chris-iot/esp8266_hardware/README.md

# esp8266_hardware
All layouts and schematics for my ESP8266 based home automation solution
