chris-iot/esp8266_hardware/PowerBoard/Simulation/Ideal_Diode.asc

M1: pmos; Si4542DY_P
M2: pmos; Si4542DY_P
Q1: pnp; BC557B
Q2: pnp; BC557B
Q3: pnp; BC557B
Q4: pnp; BC557B
R1: res; 47k
R2: res; 470k
R3: res; 47k
R4: res; 3
R5: res; 47k
R6: res; 470k
R7: res; 47k
V1: voltage; PULSE(0 3 1 0 0 2 3)
V2: voltage; PULSE(0 3.08 2 0 0 2 3)
Named nets: 0, V1, LOAD, GATEM1, V2, GATEM2
.tran 10
