chris-iot/esp8266_hardware/ESP8266_MainBoard/ESP8266_MainBoard.brd

## EAGLE design ESP8266_MainBoard/ESP8266_MainBoard.brd (2018-09-03)

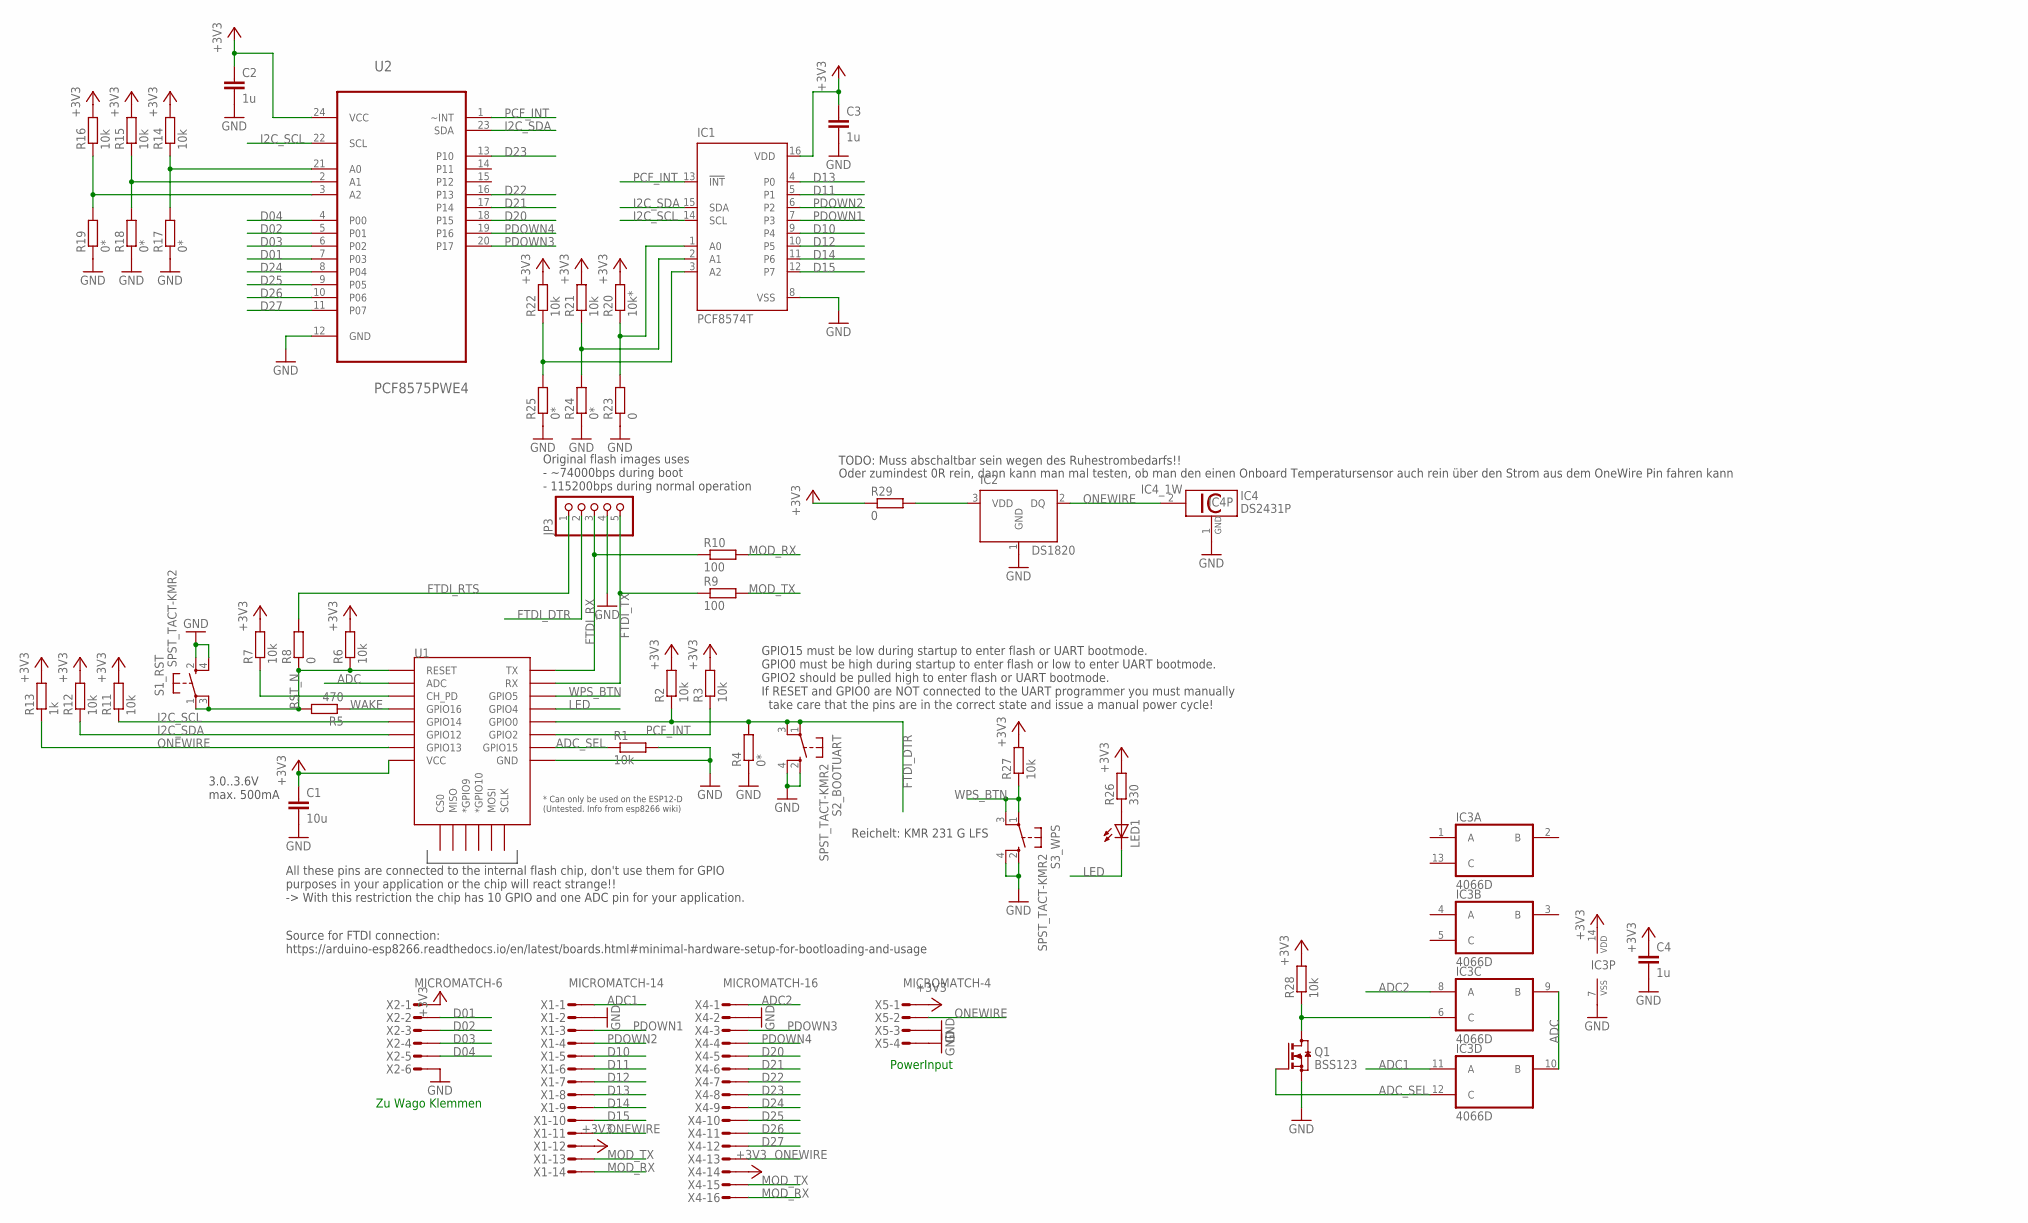
[picture p1: schematic ESP8266_MainBoard.sch]

Parts:
C1: 10u; C0805
C2, C3, C4: 1u; C0402
IC1: PCF8574T; SO16W
IC2: DS1820; TO-92
IC3: 4066D; SO14
IC4: DS2431P; TSOC6
JP3: PINHD-1X5; 1X05
LED1: LEDCHIP-LED0603; CHIP-LED0603
Q1: BSS123; SOT23
R1, R2, R3, R6, R7, R11, R12, R14, R15, R16, R21, R22, R27, R28: 10k; R0402
R4, R17, R18, R19, R24, R25: 0*; R0402
R5: 470; R0402
R8, R23, R29: 0; R0402
R9, R10: 100; R0402
R13: 1k; R0402
R20: 10k*; R0402
R26: 330; R0402
S1_RST, S2_BOOTUART, S3_WPS: SPST_TACT-KMR2; KMR2
U1: ESP12ESMD; ESP12E-SMD
U2: PCF8575PWE4; SOP65P640X120-24N
X1: MICROMATCH-14
X2: MICROMATCH-6
X4: MICROMATCH-16
X5: MICROMATCH-4

Connections:
+3V3: C1.1, C2.1, C3.1, C4.1, IC1.16 (VDD), IC3.14 (VDD), R2.2, R3.2, R6.2, R7.2, R11.2, R12.2, R13.2, R14.2, R15.2, R16.2, R20.2, R21.2, R22.2, R26.2, R27.2, R28.2, R29.1, U1.VCC, U2.24 (VCC), X1.12, X2.1, X4.14, X5.1
ADC: IC3.9 (B), IC3.10 (B), U1.ADC
ADC1: IC3.11 (A), X1.1
ADC2: IC3.8 (A), X4.1
ADC_SEL: IC3.12 (C), Q1.1 (G), R1.1, U1.GPIO15
D01: U2.7 (P03), X2.2
D02: U2.5 (P01), X2.3
D03: U2.6 (P02), X2.4
D04: U2.4 (P00), X2.5
D10: IC1.9 (P4), X1.5
D11: IC1.5 (P1), X1.6
D12: IC1.10 (P5), X1.7
D13: IC1.4 (P0), X1.8
D14: IC1.11 (P6), X1.9
D15: IC1.12 (P7), X1.10
D20: U2.18 (P15), X4.5
D21: U2.17 (P14), X4.6
D22: U2.16 (P13), X4.7
D23: U2.13 (P10), X4.8
D24: U2.8 (P04), X4.9
D25: U2.9 (P05), X4.10
D26: U2.10 (P06), X4.11
D27: U2.11 (P07), X4.12
FTDI_DTR: JP3.2, R2.1, R4.2, S2_BOOTUART.1, S2_BOOTUART.3 (P1), U1.GPIO0
FTDI_RTS: JP3.1, R8.2
FTDI_RX: JP3.3, R10.1, U1.TXD0 (TX)
FTDI_TX: JP3.5, R9.1, U1.RXD0 (RX)
GND: C1.2, C2.2, C3.2, C4.2, IC1.8 (VSS), IC2.1 (GND), IC3.7 (VSS), IC4.1 (GND), JP3.4, Q1.2 (S), R1.2, R4.1, R17.1, R18.1, R19.1, R23.1, R24.1, R25.1, S1_RST.2 (S), S1_RST.4 (S1), S2_BOOTUART.2 (S), S2_BOOTUART.4 (S1), S3_WPS.2 (S), S3_WPS.4 (S1), U1.GND, U2.12 (GND), X1.2, X2.6, X4.2, X5.3, X5.4
I2C_SCL: IC1.14 (SCL), R11.1, U1.GPIO14, U2.22 (SCL)
I2C_SDA: IC1.15 (SDA), R12.1, U1.GPIO12, U2.23 (SDA)
LED: LED1.C, U1.GPIO4
MOD_RX: R10.2, X1.14, X4.16
MOD_TX: R9.2, X1.13, X4.15
unnamed: IC3.6 (C), Q1.3 (D), R28.1
unnamed: R14.1, R17.2, U2.21 (A0)
unnamed: R15.1, R18.2, U2.2 (A1)
unnamed: R7.1, U1.CH_PD
unnamed: IC2.3 (VDD), R29.2
unnamed: R16.1, R19.2, U2.3 (A2)
unnamed: IC1.1 (A0), R20.1, R23.2
unnamed: IC1.2 (A1), R21.1, R24.2
unnamed: IC1.3 (A2), R22.1, R25.2
unnamed: LED1.A, R26.1
ONEWIRE: IC2.2 (DQ), IC4.2 (1W), R13.1, U1.GPIO13, X1.11, X4.13, X5.2
PCF_INT: IC1.13 (!INT), R3.1, U1.GPIO2, U2.1 (~INT)
PDOWN1: IC1.7 (P3), X1.3
PDOWN2: IC1.6 (P2), X1.4
PDOWN3: U2.20 (P17), X4.3
PDOWN4: U2.19 (P16), X4.4
RST_N: R5.2, R6.1, R8.1, S1_RST.1, S1_RST.3 (P1), U1.RESET
WAKE: R5.1, U1.GPIO16
WPS_BTN: R27.1, S3_WPS.1, S3_WPS.3 (P1), U1.GPIO5

Notes on the sheet:
3.0..3.6V max. 500mA
GPIO15 must be low during startup to enter flash or UART bootmode. GPIO0 must be high during startup to enter flash or low to enter UART bootmode. GPIO2 should be pulled high to enter flash or UART bootmode. If RESET and GPIO0 are NOT connected to the UART programmer you must manually take care tha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
All these pins are connected to the internal flash chip, don't use them for GPIO purposes in your application or the chip will react strange!! -> With this restriction the chip has 10 GPIO and one ADC pin for your application.
Original flash images uses - ~74000bps during boot - 115200bps during normal operation
Source for FTDI connection: https://arduino-esp8266.readthedocs.io/en/latest/boards.html#minimal-hardware-setup-for-bootloading-and-usage
Zu Wago Klemmen
PowerInput
Reichelt: KMR 231 G LFS
TODO: Muss abschaltbar sein wegen des Ruhestrombedarfs!!
Oder zumindest 0R rein, dann kann man mal testen, ob man den einen Onboard Temperatursensor auch rein über den Strom aus dem OneWire Pin fahren kann

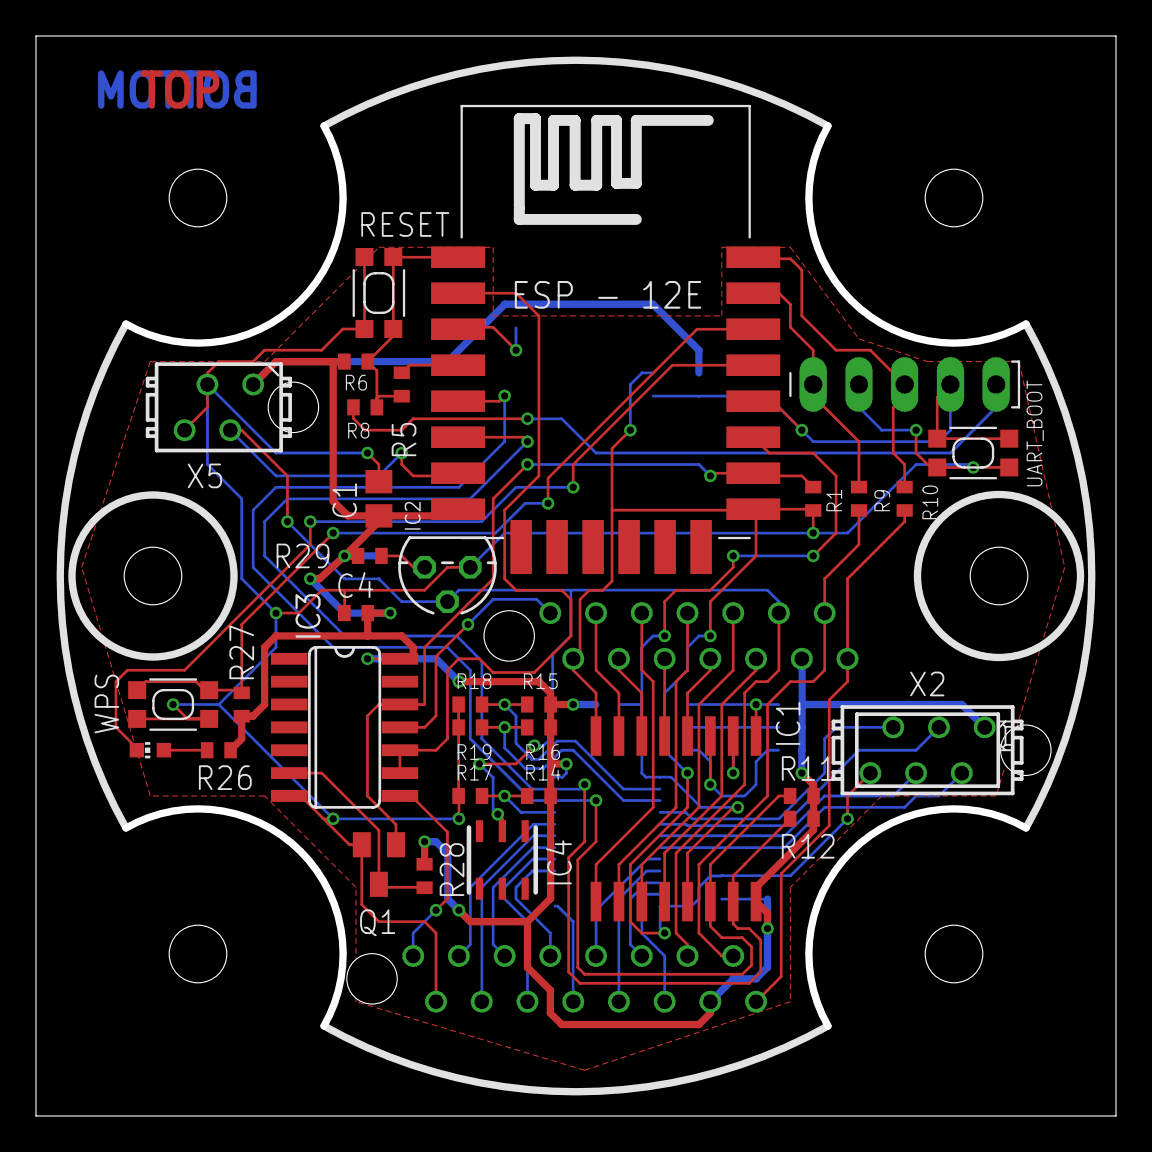
[picture p2: board ESP8266_MainBoard.brd from above]

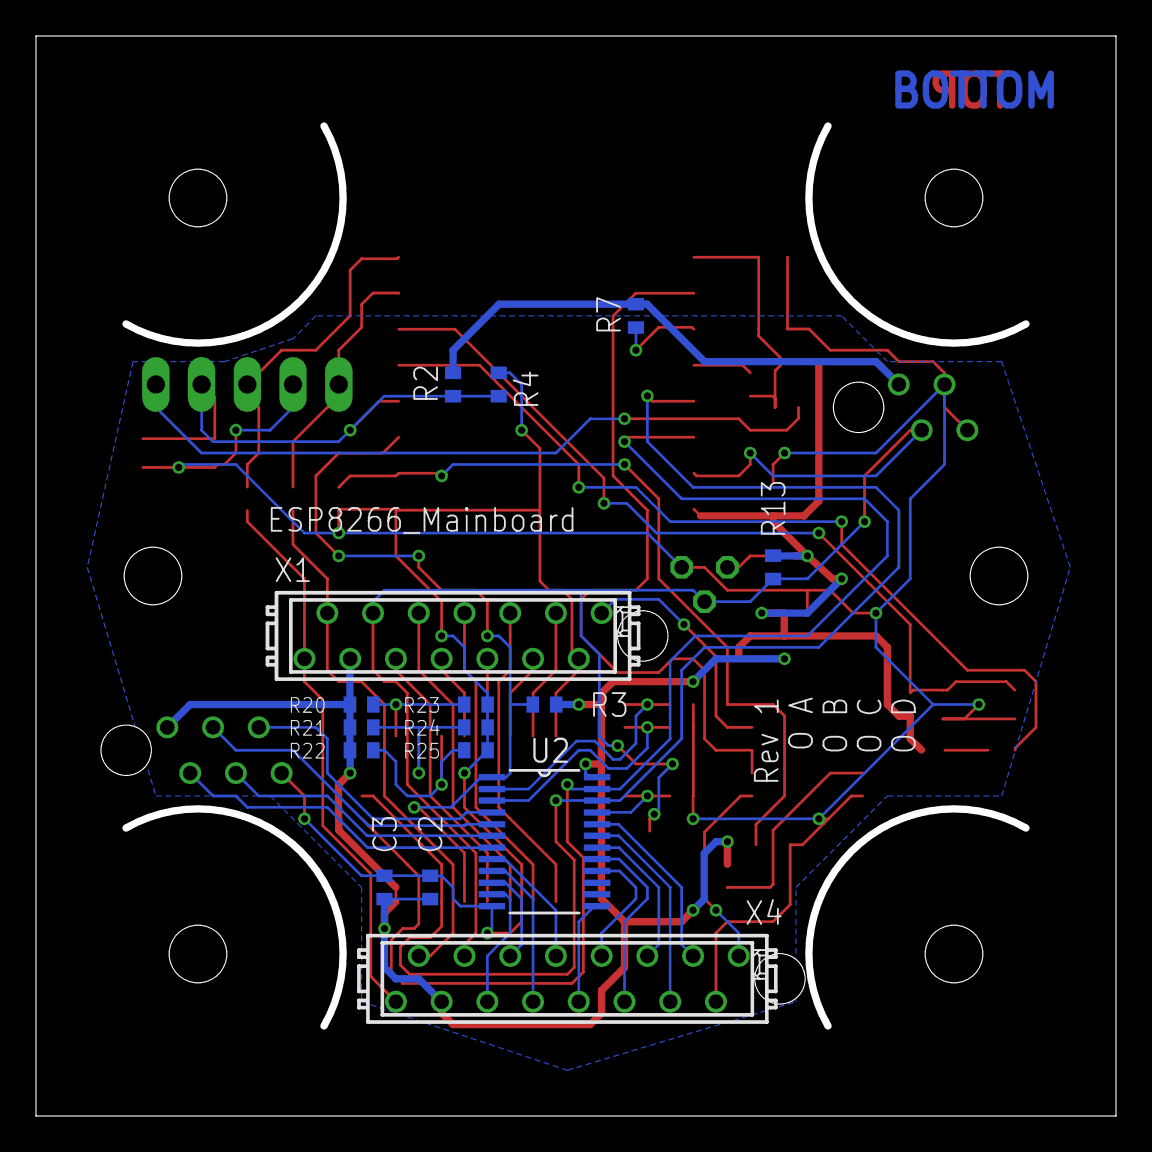
[picture p3: board ESP8266_MainBoard.brd from below]

Board: 2 copper layers, 60.0 x 60.0 mm, 49 parts (16 on the bottom side), 52 nets.
