chris-iot/esp8266_hardware/PowerBoard/PowerBoard.brd

## EAGLE design PowerBoard/PowerBoard.brd (2018-01-21)

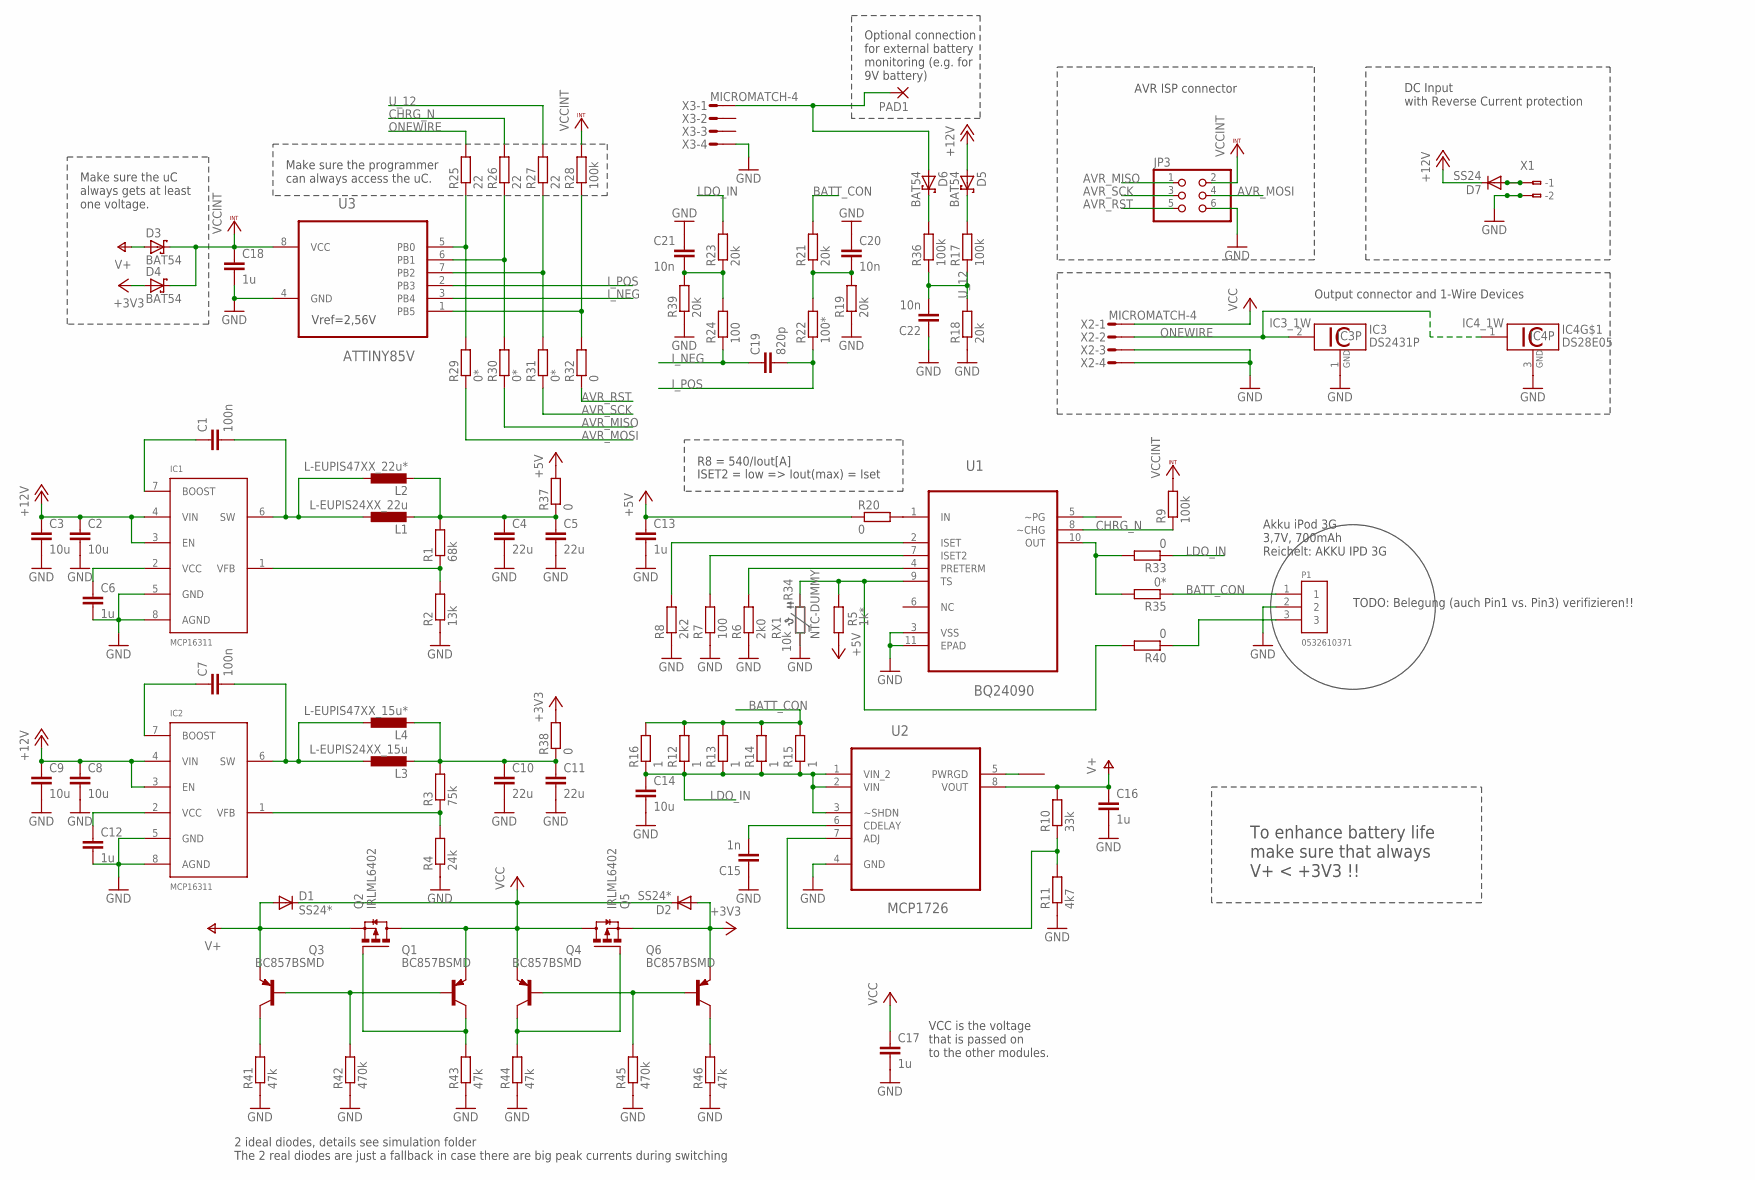
[picture p4: schematic PowerBoard.sch]

Parts:
C1, C7: 100n; C0603
C2, C3, C8, C9, C14: 10u; C1210
C4, C5, C10, C11: 22u; C1210
C6, C12, C13, C16, C17, C18: 1u; C0603
C15: 1n; C0603
C19: 820p; C0603
C20, C21, C22: 10n; C0603
D1, D2: SS24*; SMB
D3, D4, D5, D6: BAT54; SOT23
D7: SS24; SMB
IC1, IC2: MCP16311; SOP65P490X110-8N
IC3: DS2431P; TSOC6
IC4: DS28E05; SOT23
JP3: PINHD-2X3; 2X03
L1: L-EUPIS24XX_22u; PIS24XX
L2: L-EUPIS47XX_22u*; PIS47XX
L3: L-EUPIS24XX_15u; PIS24XX
L4: L-EUPIS47XX_15u*; PIS47XX
P1: 0532610371; MOLEX_0532610371
PAD1: WIREPADSMD2,54-5,08; SMD2,54-5,08
Q1, Q3, Q4, Q6: BC857BSMD; SOT23-BEC
Q2, Q5: IRLML6402; SOT23
R1: 68k; R0603
R2: 13k; R0603
R3: 75k; R0603
R4: 24k; R0603
R5: 1k*; R0603
R6: 2k0; R0603
R7, R24: 100; R0603
R8: 2k2; R0603
R9, R17, R36: 100k; R0603
R10: 33k; R0603
R11: 4k7; R0603
R12, R13, R14, R15, R16: 1; R0402
R18, R19, R21, R23, R39: 20k; R0603
R20, R33, R37, R38, R40: 0; R0603
R22: 100*; R0603
R25, R26, R27: 22; R0402
R28: 100k; R0402
R29, R30, R31: 0*; R0402
R32: 0; R0402
R34: 10k; R0603
R35: 0*; R0603
R41, R43, R44, R46: 47k; R0603
R42, R45: 470k; R0603
U1: BQ24090; SOP50P490X110-11N
U2: MCP1726; SOIC127P490X175-8N
U3: ATTINY85V; SOIC127P798X216-8N
U$1, U$3: PAD100-RND; PAD-100-RND
X1: 233-102
X2, X3: MICROMATCH-4

Connections:
+3V3: D2.A, D4.1 (A), Q5.2 (S), Q6.E, R38.2
+5V: C13.1, R5.1, R20.1, R37.2
+12V: C2.1, C3.1, C8.1, C9.1, D5.1 (A), D7.C, IC1.3 (EN), IC1.4 (VIN), IC2.3 (EN), IC2.4 (VIN)
AVR_MISO: JP3.1, R30.1
AVR_MOSI: JP3.4, R29.1
AVR_RST: JP3.5, R32.1
AVR_SCK: JP3.3, R31.1
BATT_CON: P1.1, R12.2, R13.2, R14.2, R15.2, R16.2, R21.2, R35.1
CHRG_N: R9.1, R26.2, U1.8 (~CHG)
GND: C2.2, C3.2, C4.2, C5.2, C6.2, C8.2, C9.2, C10.2, C11.2, C12.2, C13.2, C14.2, C15.1, C16.2, C17.2, C18.2, C20.1, C21.1, C22.1, IC1.5 (GND), IC1.8 (AGND), IC2.5 (GND), IC2.8 (AGND), IC3.1 (GND), IC4.3 (GND), JP3.6, P1.2, R2.1, R4.1, R6.1, R7.1, R8.1, R11.1, R18.1, R19.1, R34.1, R39.1, R41.1, R42.1, R43.1, R44.1, R45.1, R46.1, U1.3 (VSS), U1.11 (EPAD), U2.4 (GND), U3.4 (GND), X1.A2 (-2), X1.B2 (B-2), X2.3, X2.4, X3.4
I_NEG: C19.1, R24.1, U3.3 (PB4)
I_POS: C19.2, R22.1, U3.2 (PB3)
LDO_IN: C14.1, R12.1, R13.1, R14.1, R15.1, R16.1, R23.2, R33.1, U2.1 (VIN_2), U2.2 (VIN), U2.3 (~SHDN)
unnamed: C1.1, IC1.7 (BOOST)
unnamed: C1.2, IC1.6 (SW), L1.2 (1), L2.2 (1)
unnamed: U2.5 (PWRGD), U$3.P$1
unnamed: R8.2, U1.2 (ISET)
unnamed: IC1.1 (VFB), R1.1, R2.2
unnamed: R7.2, U1.7 (ISET2)
unnamed: C6.1, IC1.2 (VCC)
unnamed: R6.2, U1.4 (PRETERM)
unnamed: C7.1, IC2.7 (BOOST)
unnamed: C7.2, IC2.6 (SW), L3.2 (1), L4.2 (1)
unnamed: IC2.1 (VFB), R3.1, R4.2
unnamed: C12.1, IC2.2 (VCC)
unnamed: R5.2, R34.2, R40.2, U1.9 (TS)
unnamed: U1.5 (~PG), U$1.P$1
unnamed: C15.2, U2.6 (CDELAY)
unnamed: R28.1, R32.2, U3.1 (PB5)
unnamed: D6.3 (C), R36.2
unnamed: R27.1, R31.2, U3.7 (PB2)
unnamed: R26.1, R30.2, U3.6 (PB1)
unnamed: R10.1, R11.2, U2.7 (ADJ)
unnamed: C21.2, R23.1, R24.2, R39.2
unnamed: D7.A, X1.A1 (-1), X1.B1 (B-1)
unnamed: R25.1, R29.2, U3.5 (PB0)
unnamed: D6.1 (A), PAD1.1, X3.1
unnamed: C4.1, C5.1, L1.1 (2), L2.1 (2), R1.2, R37.1
unnamed: C10.1, C11.1, L3.1 (2), L4.1 (2), R3.2, R38.1
unnamed: C20.2, R19.2, R21.1, R22.2
unnamed: D5.3 (C), R17.2
unnamed: R20.2, U1.1 (IN)
unnamed: R33.2, R35.2, U1.10 (OUT)
unnamed: P1.3, R40.1
unnamed: Q1.C, Q2.1 (G), R43.2
unnamed: Q1.B, Q3.B, R42.2
unnamed: Q3.C, R41.2
unnamed: Q4.C, Q5.1 (G), R44.2
unnamed: Q4.B, Q6.B, R45.2
unnamed: Q6.C, R46.2
ONEWIRE: IC3.2 (1W), IC4.1 (1W), R25.2, X2.2
U_12: C22.2, R17.1, R18.2, R27.2, R36.1
V+: C16.1, D1.A, D3.1 (A), Q2.2 (S), Q3.E, R10.2, U2.8 (VOUT)
VCC: C17.1, D1.C, D2.C, Q1.E, Q2.3 (D), Q4.E, Q5.3 (D), X2.1
VCCINT: C18.1, D3.3 (C), D4.3 (C), JP3.2, R9.2, R28.2, U3.8 (VCC)

Notes on the sheet:
VCC is the voltage that is passed on to the other modules.
Optional connection for external battery monitoring (e.g. for 9V battery)
Akku iPod 3G 3,7V, 700mAh Reichelt: AKKU IPD 3G
R8 = 540/Iout[A]
To enhance battery life make sure that always V+ < +3V3 !!
ISET2 = low => Iout(max) = Iset
Vref=2,56V
TODO: Belegung (auch Pin1 vs. Pin3) verifizieren!!
Make sure the uC always gets at least one voltage.
Make sure the programmer can always access the uC.
AVR ISP connector
DC Input with Reverse Current protection
Output connector and 1-Wire Devices
2 ideal diodes, details see simulation folder The 2 real diodes are just a fallback in case there are big peak currents during switching

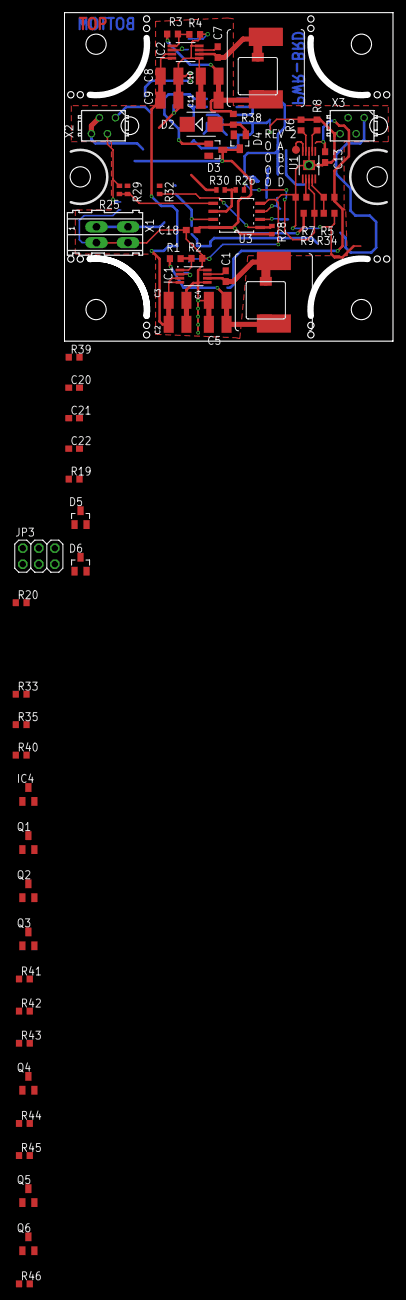
[picture p5: board PowerBoard.brd from above]

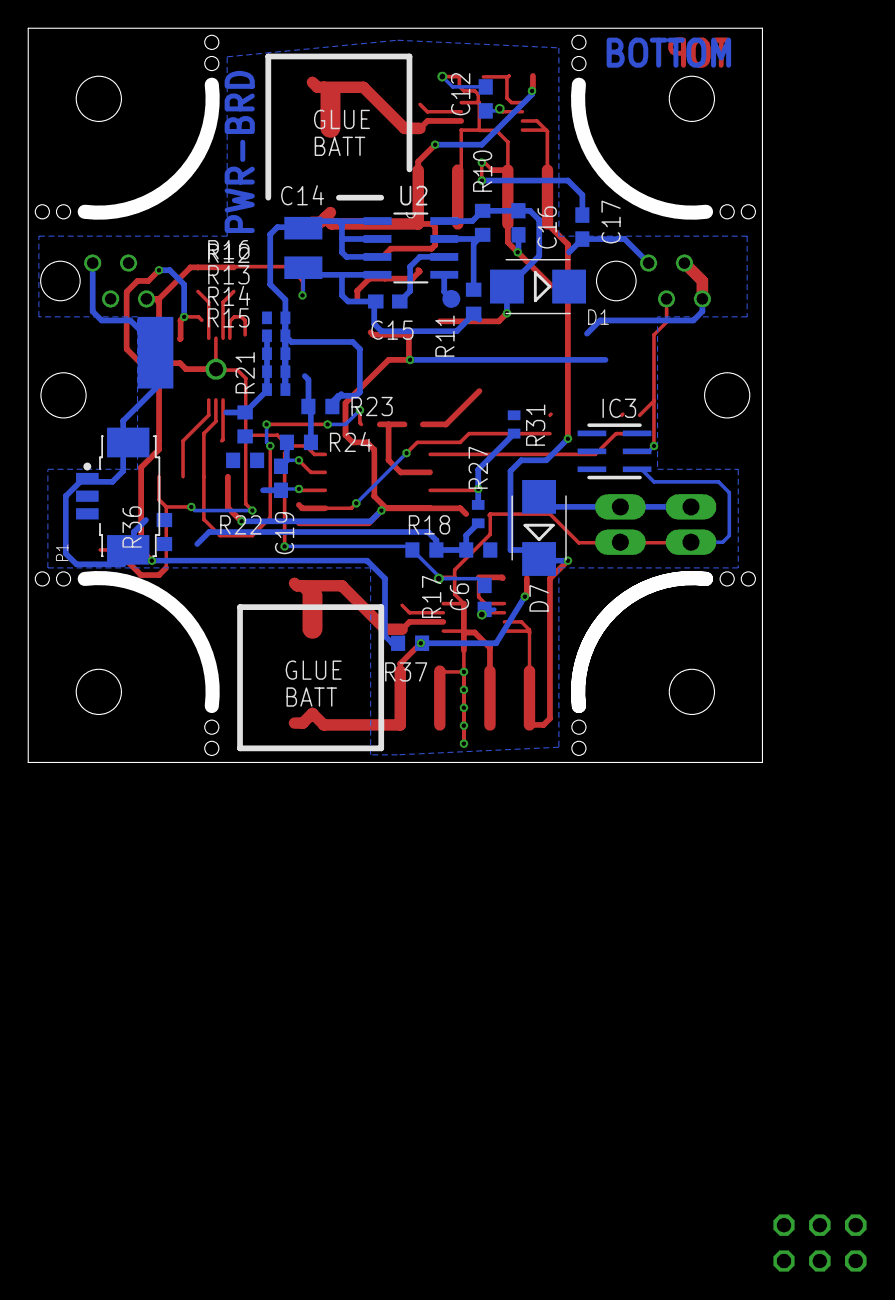
[picture p6: board PowerBoard.brd from below]

Board: 2 copper layers, 52.0 x 52.0 mm, 100 parts (31 on the bottom side), 55 nets.
