chris-iot/esp8266_hardware/(threads)

Thread 2 (2018-01-21):

Also add the hardware of the "heating switch" here

chris-iot, 2018-01-21:
Add hints on how to build the unit and give a warning about the danger of high voltage AC.

...and give the stuff a bit more generic name - "heating switch" is misleading...
