chris-iot/esp8266_hardware/(commit log)

2018-01-21 Initial commit of the state that has been produced up to now
    [ESP8266_MainBoard.GBL, ESP8266_MainBoard.GBO, ESP8266_MainBoard.GBP, ESP8266_MainBoard.GBS, ESP8266_MainBoard.GTL, ESP8266_MainBoard.GTO, ESP8266_MainBoard.GTP, ESP8266_MainBoard.GTS]
2018-01-21 Added all inputs from the bringup phase of Rev0
    [PowerBoard.brd, PowerBoard.sch]
2018-01-21 Added inputs for Rev2 of PowerBoard to schematic
    [ESP8266_MainBoard.GBL, ESP8266_MainBoard.GBO, ESP8266_MainBoard.GBP, ESP8266_MainBoard.GBS, ESP8266_MainBoard.GTL, ESP8266_MainBoard.GTO, ESP8266_MainBoard.GTP, ESP8266_MainBoard.GTS]
2018-01-21 Little directory structure cleanup
    [ESP8266_MainBoard.csv, ESP8266_MainBoard_reichelt.csv]
2018-01-21 Further cleanups
    [ESP8266_MainBoard.csv, ESP8266_MainBoard_reichelt.csv]
2018-01-21 Cleaning up
    [ESP8266_MainBoard.GBL, ESP8266_MainBoard.GBO, ESP8266_MainBoard.GBP, ESP8266_MainBoard.GBS, ESP8266_MainBoard.GTL, ESP8266_MainBoard.GTO, ESP8266_MainBoard.GTP, ESP8266_MainBoard.GTS]
2018-01-21 Again Cleanup
    [ESP8266_MainBoard.GBL, ESP8266_MainBoard.GBO, ESP8266_MainBoard.GBP, ESP8266_MainBoard.GBS, ESP8266_MainBoard.GTL, ESP8266_MainBoard.GTO, ESP8266_MainBoard.GTP, ESP8266_MainBoard.GTS]
2018-01-21 Optical cleanup of the schematic, added ideal diodes and some other stuff from the TODO list
    [PowerBoard.brd, PowerBoard.sch]
2018-09-03 R13 von 4k7 nach 1k
    [ESP8266_MainBoard.brd, ESP8266_MainBoard.sch]
